AlexandreRouma/dc_sdr/README.md

# DEFCON SDR Badge

The firmware included here is not finished and the hardware isn't fully tested. Use at your own risk.

Make sure to read the license (the file is `/license`). The entire content of this repository is **NOT for commercial purposes**.
