AlexandreRouma/dc_sdr/full_assembly/full_assembly.FCStd

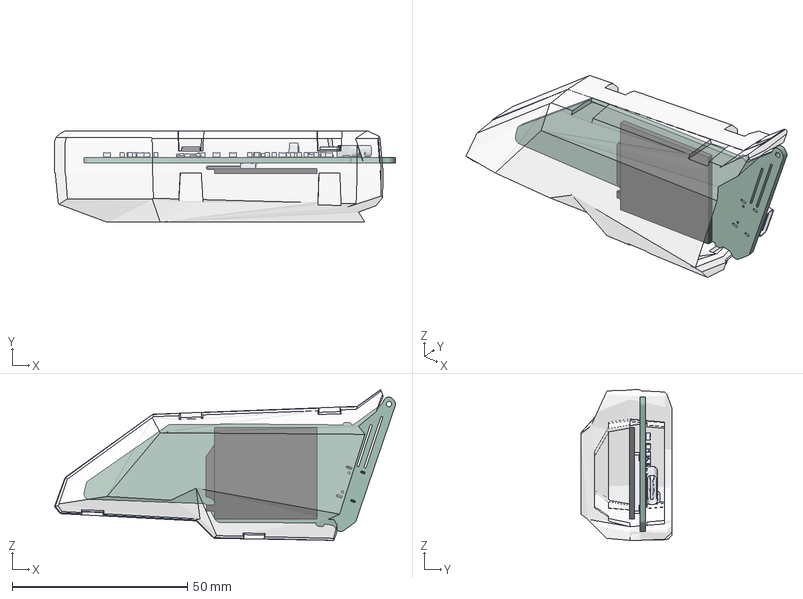
[picture p1: CAD file, 2023-07-31]
full_assembly/full_assembly.FCStd
97.3 x 26.1 x 43.2 mm
dc_sdr PCB
Badge chamber test fit
