AlexandreRouma/dc_sdr/lcd0_model/lcd0_model-BodyPad002.step

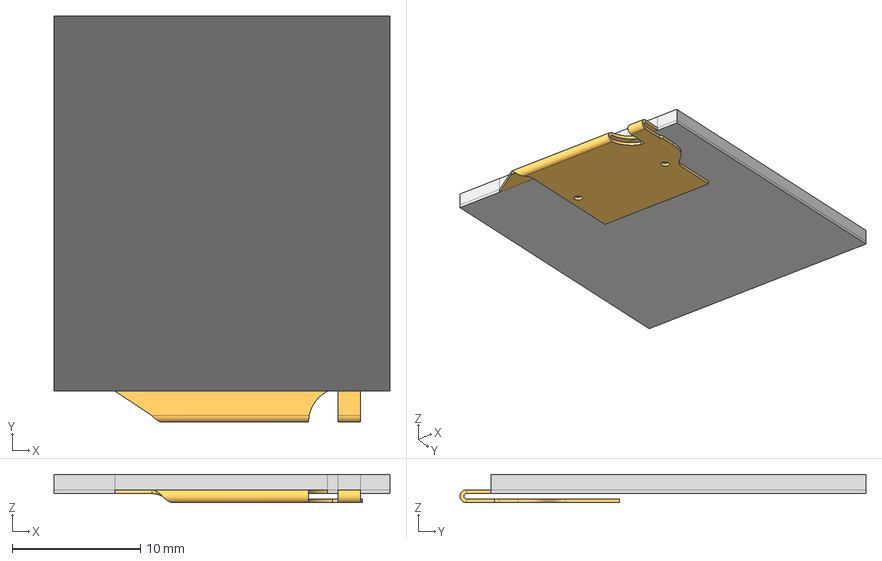
[picture p2: CAD file, 2023-07-31]
lcd0_model/lcd0_model-BodyPad002.step
26.2 x 31.6 x 2.20 mm
