AlexandreRouma/dc_sdr/lcd1_model/lcd1_model.FCStd

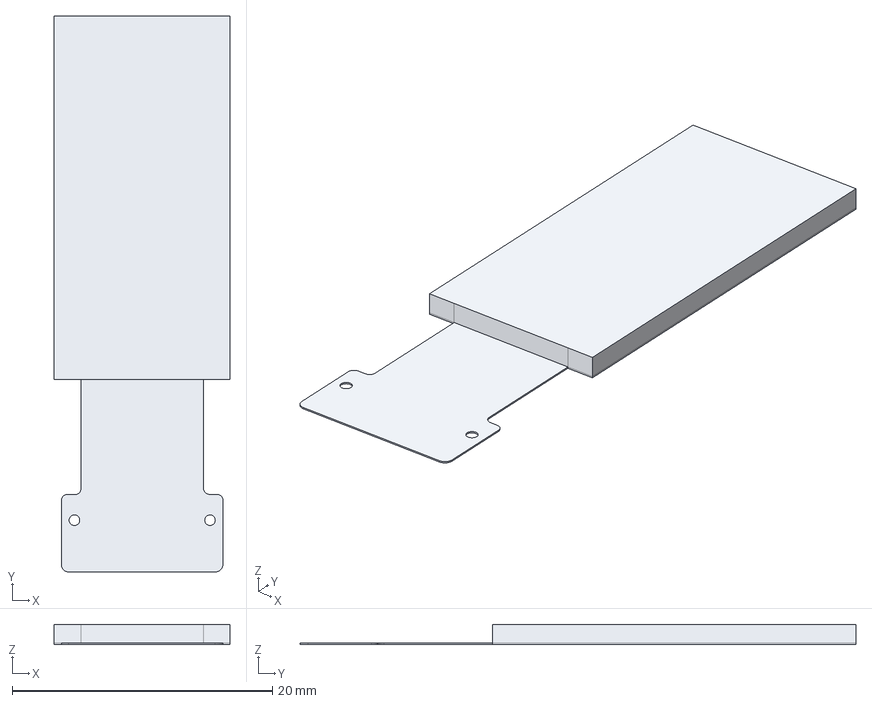
[picture p3: CAD file, 2023-07-31]
lcd1_model/lcd1_model.FCStd
13.5 x 42.8 x 1.54 mm
