AlexandreRouma/dc_sdr/oled/oled-BodyPad001.step

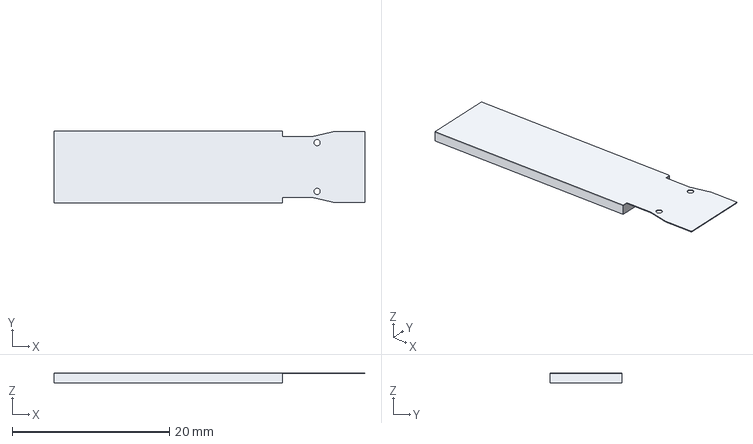
[picture p4: CAD file, 2023-07-31]
oled/oled-BodyPad001.step
39.6 x 9.20 x 1.30 mm
