AlexandreRouma/dc_sdr/lcd0_model/lcd0_model-BodyPad001.step

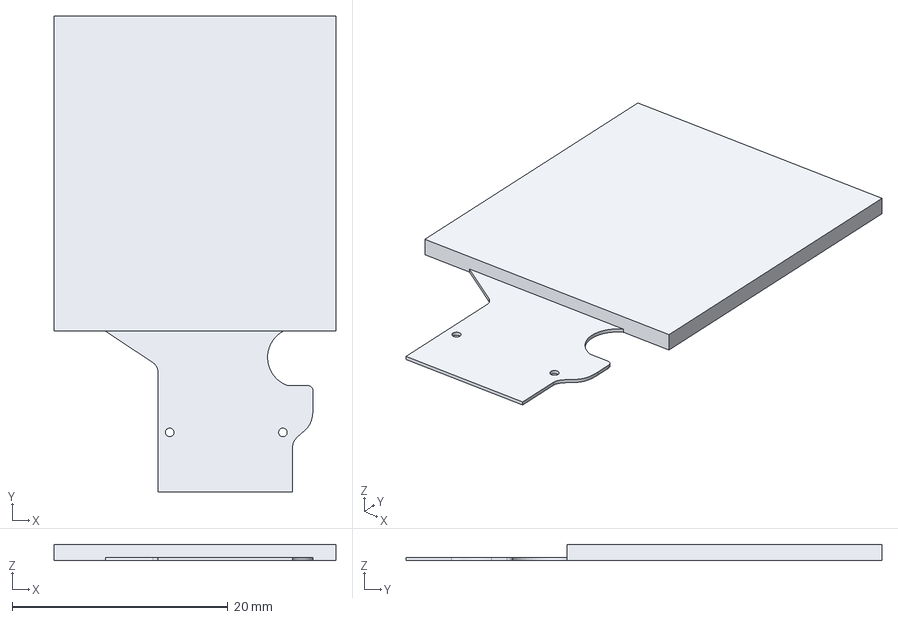
[picture p5: CAD file, 2023-07-31]
lcd0_model/lcd0_model-BodyPad001.step
26.2 x 44.1 x 1.50 mm
