AlexandreRouma/dc_sdr/(list of files, cad)

Other CAD files:
lcd0_model/lcd0_model.FCStd
lcd1_model/lcd1_model-BodyPad001.step
oled/oled.FCStd
