AlexandreRouma/dc_sdr/dc_sdr.kicad_pcb

## KiCad design dc_sdr.kicad_pcb (2023-07-31)

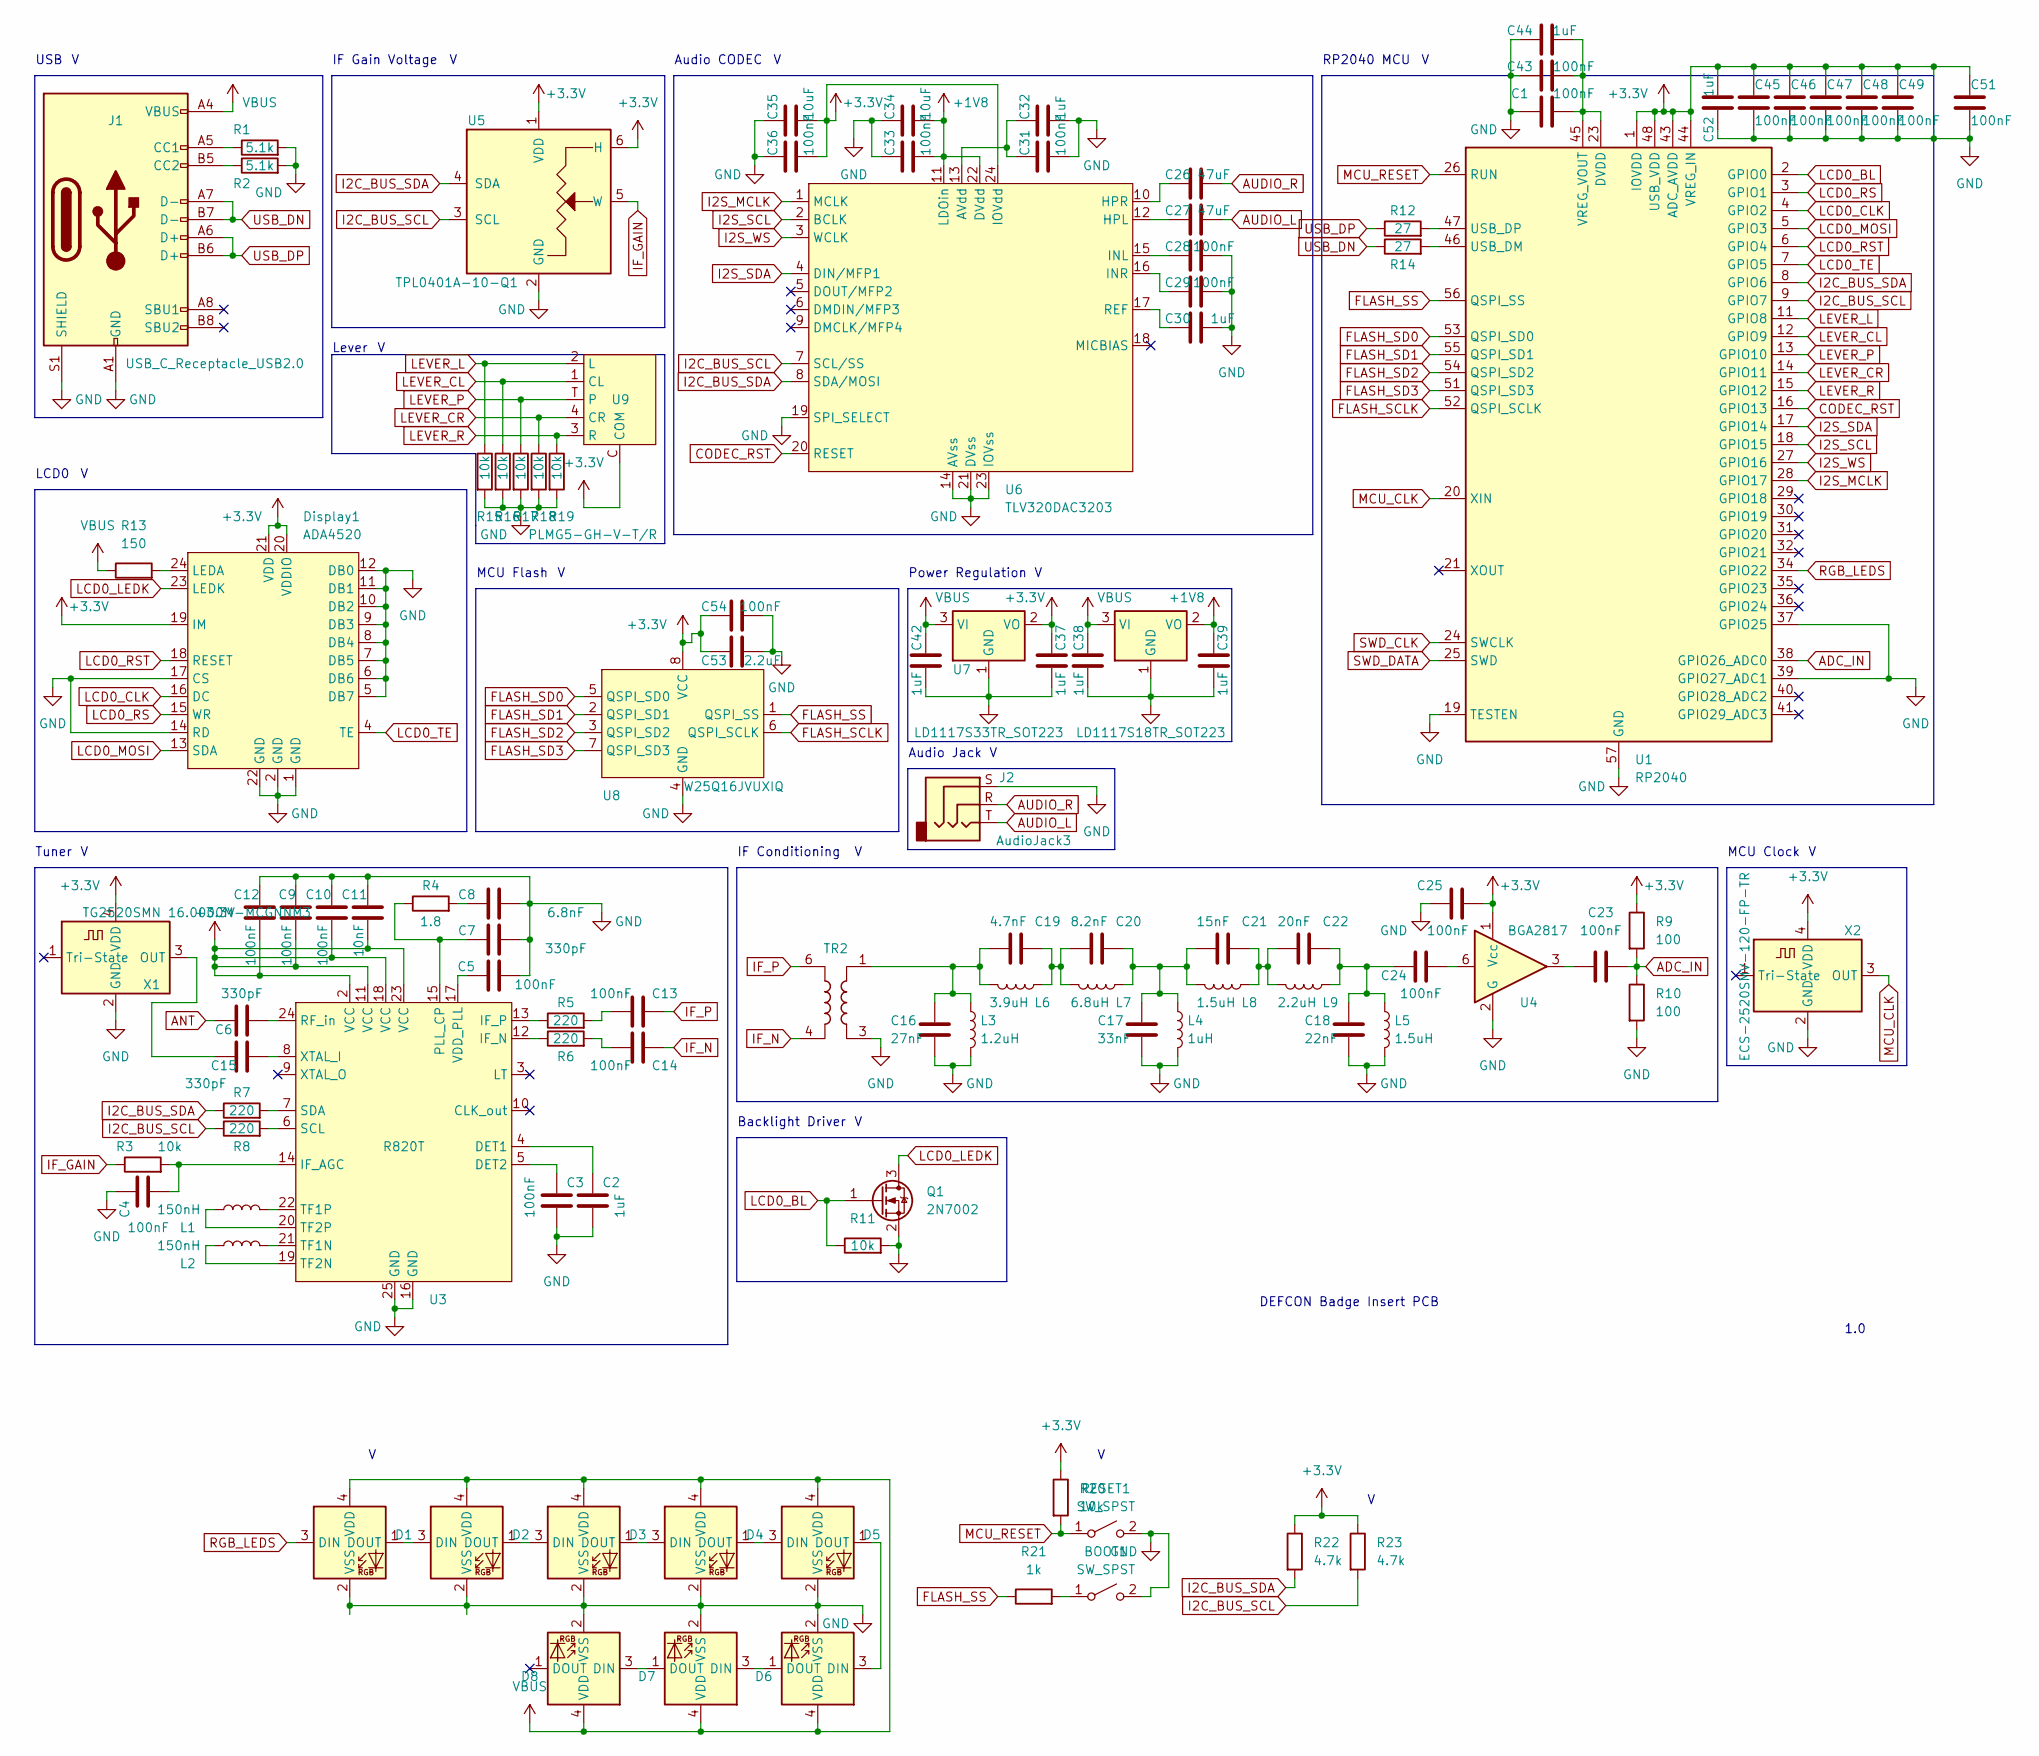
[picture p6: schematic dc_sdr.kicad_sch]

Parts:
BOOT1: SW_SPST; SW_SPST_B3U-1000P-B
C1, C3, C4, C5, C9, C10, C12, C13, C14, C23, C24, C25, C28, C29, C31, C33, C36, C43, C45, C46, C47, C48, C49, C51, C54: 100nF; C_0805_2012Metric_Pad1.18x1.45mm_HandSolder
C2, C30, C32, C37, C38, C39, C42, C44, C52: 1uF; C_0805_2012Metric_Pad1.18x1.45mm_HandSolder
C6, C7, C15: 330pF; C_0805_2012Metric_Pad1.18x1.45mm_HandSolder
C8: 6.8nF; C_0805_2012Metric_Pad1.18x1.45mm_HandSolder
C11: 10nF; C_0805_2012Metric_Pad1.18x1.45mm_HandSolder
C16: 27nF; C_0805_2012Metric_Pad1.18x1.45mm_HandSolder
C17: 33nF; C_0805_2012Metric_Pad1.18x1.45mm_HandSolder
C18: 22nF; C_0805_2012Metric_Pad1.18x1.45mm_HandSolder
C19: 4.7nF; C_0805_2012Metric_Pad1.18x1.45mm_HandSolder
C20: 8.2nF; C_0805_2012Metric_Pad1.18x1.45mm_HandSolder
C21: 15nF; C_0805_2012Metric_Pad1.18x1.45mm_HandSolder
C22: 20nF; C_0805_2012Metric_Pad1.18x1.45mm_HandSolder
C26, C27: 47uF; C_0805_2012Metric_Pad1.18x1.45mm_HandSolder
C34, C35: 10uF; C_0805_2012Metric_Pad1.18x1.45mm_HandSolder
C53: 2.2uF; C_0805_2012Metric_Pad1.18x1.45mm_HandSolder
D1, D2, D3, D4, D5, D6, D7, D8: LED_WS2812B-2020_PLCC4_2.0x2.0mm
Display1: ADA4520; AMPHENOL_SFV24R-2STE1HLF
J1: USB_C_Receptacle_USB2.0; USB_C_Receptacle_GCT_USB4105-xx-A_16P_TopMnt_Horizontal
J2: AudioJack3; Jack_3.5mm_CUI_SJ-3523-SMT_Horizontal
L1, L2: 150nH; L_0805_2012Metric_Pad1.15x1.40mm_HandSolder
L3: 1.2uH; L_0805_2012Metric_Pad1.15x1.40mm_HandSolder
L4: 1uH; L_0805_2012Metric_Pad1.15x1.40mm_HandSolder
L5, L8: 1.5uH; L_0805_2012Metric_Pad1.15x1.40mm_HandSolder
L6: 3.9uH; L_0805_2012Metric_Pad1.15x1.40mm_HandSolder
L7: 6.8uH; L_0805_2012Metric_Pad1.15x1.40mm_HandSolder
L9: 2.2uH; L_0805_2012Metric_Pad1.15x1.40mm_HandSolder
Q1: 2N7002; SOT-23
R1, R2: 5.1k; R_0805_2012Metric_Pad1.20x1.40mm_HandSolder
R3, R11, R15, R16, R17, R18, R19, R20: 10k; R_0805_2012Metric_Pad1.20x1.40mm_HandSolder
R4: 1.8; R_0805_2012Metric_Pad1.20x1.40mm_HandSolder
R5, R6, R7, R8: 220; R_0805_2012Metric_Pad1.20x1.40mm_HandSolder
R9, R10: 100; R_0805_2012Metric_Pad1.20x1.40mm_HandSolder
R12, R14: 27; R_0805_2012Metric_Pad1.20x1.40mm_HandSolder
R13: 150; R_0805_2012Metric_Pad1.20x1.40mm_HandSolder
R21: 1k; R_0805_2012Metric_Pad1.20x1.40mm_HandSolder
R22, R23: 4.7k; R_0805_2012Metric_Pad1.20x1.40mm_HandSolder
RESET1: SW_SPST; SW_SPST_B3U-1000P-B
TR2: Transformer_MiniCircuits_AT224-1A
U1: RP2040; QFN-56-1EP_7x7mm_P0.4mm_EP3.2x3.2mm
U3: R820T; QFN-24-1EP_4x4mm_P0.5mm_EP2.8x2.8mm
U4: BGA2817; SOT-363_SC-70-6
U5: TPL0401A-10-Q1; Texas_R-PDSO-G6
U6: TLV320DAC3203; VQFN-24-1EP_4x4mm_P0.5mm_EP2.5x2.5mm
U7: LD1117S33TR_SOT223; SOT-223-3_TabPin2
U8: W25Q16JVUXIQ; SON50P300X200X60-9N
U9: PLMG5-GH-V-T/R; PLMG5-GH-V-T_R
U11: LD1117S18TR_SOT223; SOT-223-3_TabPin2
X1: TG2520SMN 16.0000M-MCGNNM3; Oscillator_SMD_ECS_2520MV-xxx-xx-4Pin_2.5x2.0mm
X2: ECS-2520SMV-120-FP-TR; Oscillator_SMD_ECS_2520MV-xxx-xx-4Pin_2.5x2.0mm

Connections:
+1V8: C33.2, C34.2, C39.1, U6.11 (LDOin), U6.22 (DVdd), U11.2 (VO)
+3.3V: C9.2, C10.2, C11.2, C12.2, C25.2, C35.2, C36.2, C37.1, C45.1, C46.1, C47.1, C48.1, C49.1, C51.1, C52.2, C53.1, C54.1, Display1.19 (IM), Display1.20 (VDDIO), Display1.21 (VDD), R9.1, R20.1, R22.1, R23.1, U1.1 (IOVDD), U1.10 (IOVDD), U1.22 (IOVDD), U1.33 (IOVDD), U1.42 (IOVDD), U1.43 (ADC_AVDD), U1.44 (VREG_IN), U1.48 (USB_VDD), U1.49 (IOVDD), U3.2 (VCC), U3.11 (VCC), U3.18 (VCC), U3.23 (VCC), U4.1 (Vcc), U5.1 (VDD), U5.6 (H), U6.24 (IOVdd), U7.2 (VO), U8.8 (VCC), U9.C (COM), X1.4 (VDD), X2.4 (VDD); also elsewhere on the board
ADC_IN: C23.2, R9.2, R10.1, U1.38 (GPIO26_ADC0)
ANT: C6.1
AUDIO_L: C27.2, J2.T
AUDIO_R: C26.2, J2.R
CODEC_RST: U1.16 (GPIO13), U6.20 (RESET)
FLASH_SCLK: U1.52 (QSPI_SCLK), U8.6 (QSPI_SCLK)
FLASH_SD0: U1.53 (QSPI_SD0), U8.5 (QSPI_SD0)
FLASH_SD1: U1.55 (QSPI_SD1), U8.2 (QSPI_SD1)
FLASH_SD2: U1.54 (QSPI_SD2), U8.3 (QSPI_SD2)
FLASH_SD3: U1.51 (QSPI_SD3), U8.7 (QSPI_SD3)
FLASH_SS: R21.1, U1.56 (QSPI_SS), U8.1 (QSPI_SS)
GND: BOOT1.2 (B), C1.1, C2.2, C3.2, C4.1, C5.2, C7.2, C8.2, C9.1, C10.1, C11.1, C12.1, C16.2, C17.2, C18.2, C25.1, C28.2, C29.2, C30.2, C31.2, C32.2, C33.1, C34.1, C35.1, C36.1, C37.2, C38.2, C39.2, C42.2, C43.1, C44.1, C45.2, C46.2, C47.2, C48.2, C49.2, C51.2, C52.1, C53.2, C54.2, D1.2 (VSS), D2.2 (VSS), D3.2 (VSS), D4.2 (VSS), D5.2 (VSS), D6.2 (VSS), D7.2 (VSS), D8.2 (VSS), Display1.1 (GND), Display1.2 (GND), Display1.5 (DB7), Display1.6 (DB6), Display1.7 (DB5), Display1.8 (DB4), Display1.9 (DB3), Display1.10 (DB2), Display1.11 (DB1), Display1.12 (DB0), Display1.14 (RD), Display1.17 (CS), Display1.22 (GND), J1.A1 (GND), J1.A12 (GND), J1.B1 (GND), J1.B12 (GND), J1.S1 (SHIELD), J2.S, L3.2, L4.2, L5.2, Q1.2 (S), R1.2, R2.2, R10.2, R11.2, R15.2, R16.2, R17.2, R18.2, R19.2, RESET1.2 (B), TR2.3, U1.19 (TESTEN), U1.37 (GPIO25), U1.39 (GPIO27_ADC1), U1.57 (GND), U3.16 (GND), U3.25 (GND), U4.2 (G), U4.4 (G), U4.5 (G), U5.2 (GND), U6.14 (AVss), U6.19 (SPI_SELECT), U6.21 (DVss), U6.23 (IOVss), U7.1 (GND), U8.4 (GND), U11.1 (GND), X1.2 (GND), X2.2 (GND); also elsewhere on the board
I2C_BUS_SCL: R8.1, R23.2, U1.9 (GPIO7), U5.3 (SCL), U6.7 (SCL/SS)
I2C_BUS_SDA: R7.1, R22.2, U1.8 (GPIO6), U5.4 (SDA), U6.8 (SDA/MOSI)
I2S_MCLK: U1.28 (GPIO17), U6.1 (MCLK)
I2S_SCL: U1.18 (GPIO15), U6.2 (BCLK)
I2S_SDA: U1.17 (GPIO14), U6.4 (DIN/MFP1)
I2S_WS: U1.27 (GPIO16), U6.3 (WCLK)
IF_GAIN: R3.1, U5.5 (W)
IF_N: C14.2, TR2.4
IF_P: C13.2, TR2.6
LCD0_BL: Q1.1 (G), R11.1, U1.2 (GPIO0)
LCD0_CLK: Display1.16 (DC), U1.4 (GPIO2)
LCD0_LEDK: Display1.23 (LEDK), Q1.3 (D)
LCD0_MOSI: Display1.13 (SDA), U1.5 (GPIO3)
LCD0_RS: Display1.15 (WR), U1.3 (GPIO1)
LCD0_RST: Display1.18 (RESET), U1.6 (GPIO4)
LCD0_TE: Display1.4 (TE), U1.7 (GPIO5)
LEVER_CL: R16.1, U1.12 (GPIO9), U9.1 (CL)
LEVER_CR: R18.1, U1.14 (GPIO11), U9.4 (CR)
LEVER_L: R15.1, U1.11 (GPIO8), U9.2 (L)
LEVER_P: R17.1, U1.13 (GPIO10), U9.T
LEVER_R: R19.1, U1.15 (GPIO12), U9.3 (R)
MCU_CLK: U1.20 (XIN), X2.3 (OUT)
MCU_RESET: R20.2, RESET1.1 (A), U1.26 (RUN)
unnamed: BOOT1.1 (A), R21.2
unnamed: C8.1, R4.2
unnamed: C13.1, R5.2
unnamed: C14.1, R6.2
unnamed: C16.1, C19.2, L3.1, L6.2, TR2.1
unnamed: C17.1, C20.1, C21.2, L4.1, L7.1, L8.2
unnamed: C18.1, C22.1, C24.1, L5.1, L9.1
unnamed: C19.1, C20.2, L6.1, L7.2
unnamed: C21.1, C22.2, L8.1, L9.2
unnamed: C23.1, U4.3
unnamed: C24.2, U4.6
unnamed: D1.1 (DOUT), D2.3 (DIN)
unnamed: D2.1 (DOUT), D3.3 (DIN)
unnamed: D3.1 (DOUT), D4.3 (DIN)
unnamed: D4.1 (DOUT), D5.3 (DIN)
unnamed: D5.1 (DOUT), D6.3 (DIN)
unnamed: D6.1 (DOUT), D7.3 (DIN)
unnamed: D7.1 (DOUT), D8.3 (DIN)
unnamed: Display1.24 (LEDA), R13.2
unnamed: J1.A5 (CC1), R1.1
unnamed: J1.B5 (CC2), R2.1
unnamed: R14.2, U1.46 (USB_DM)
unnamed: R12.2, U1.47 (USB_DP)
unnamed: C1.2, C43.2, C44.2, U1.23 (DVDD), U1.45 (VREG_VOUT), U1.50 (DVDD)
unnamed: C2.1, U3.4 (DET1)
unnamed: C3.1, U3.5 (DET2)
unnamed: C4.2, R3.2, U3.14 (IF_AGC)
unnamed: R6.1, U3.12 (IF_N)
unnamed: R5.1, U3.13 (IF_P)
unnamed: C7.1, R4.1, U3.15 (PLL_CP)
unnamed: C6.2, U3.24 (RF_in)
unnamed: R8.2, U3.6 (SCL)
unnamed: R7.2, U3.7 (SDA)
unnamed: L2.2, U3.21 (TF1N)
unnamed: L1.2, U3.22 (TF1P)
unnamed: L2.1, U3.19 (TF2N)
unnamed: L1.1, U3.20 (TF2P)
unnamed: C5.1, U3.17 (VDD_PLL)
unnamed: C15.2, U3.8 (XTAL_I)
unnamed: C31.1, C32.1, U6.13 (AVdd)
unnamed: C27.1, U6.12 (HPL)
unnamed: C26.1, U6.10 (HPR)
unnamed: C28.1, U6.15 (INL)
unnamed: C29.1, U6.16 (INR)
unnamed: C30.1, U6.17 (REF)
unnamed: C15.1, X1.3 (OUT)
RGB_LEDS: D1.3 (DIN), U1.34 (GPIO22)
SWD_CLK: U1.24 (SWCLK)
SWD_DATA: U1.25 (SWD)
USB_DN: J1.A7 (D-), J1.B7 (D-), R14.1
USB_DP: J1.A6 (D+), J1.B6 (D+), R12.1
VBUS: C38.1, C42.1, D1.4 (VDD), D2.4 (VDD), D3.4 (VDD), D4.4 (VDD), D5.4 (VDD), D6.4 (VDD), D7.4 (VDD), D8.4 (VDD), J1.A4 (VBUS), J1.A9 (VBUS), J1.B4 (VBUS), J1.B9 (VBUS), R13.1, U7.3 (VI), U11.3 (VI)

Notes on the sheet:
DEFCON Badge Insert PCB
1.0
IF Conditioning
IF Gain Voltage
LCD0
Lever
Power Regulation
Tuner
USB
Backlight Driver
RP2040 MCU
MCU Clock
MCU Flash
Audio CODEC
Audio Jack

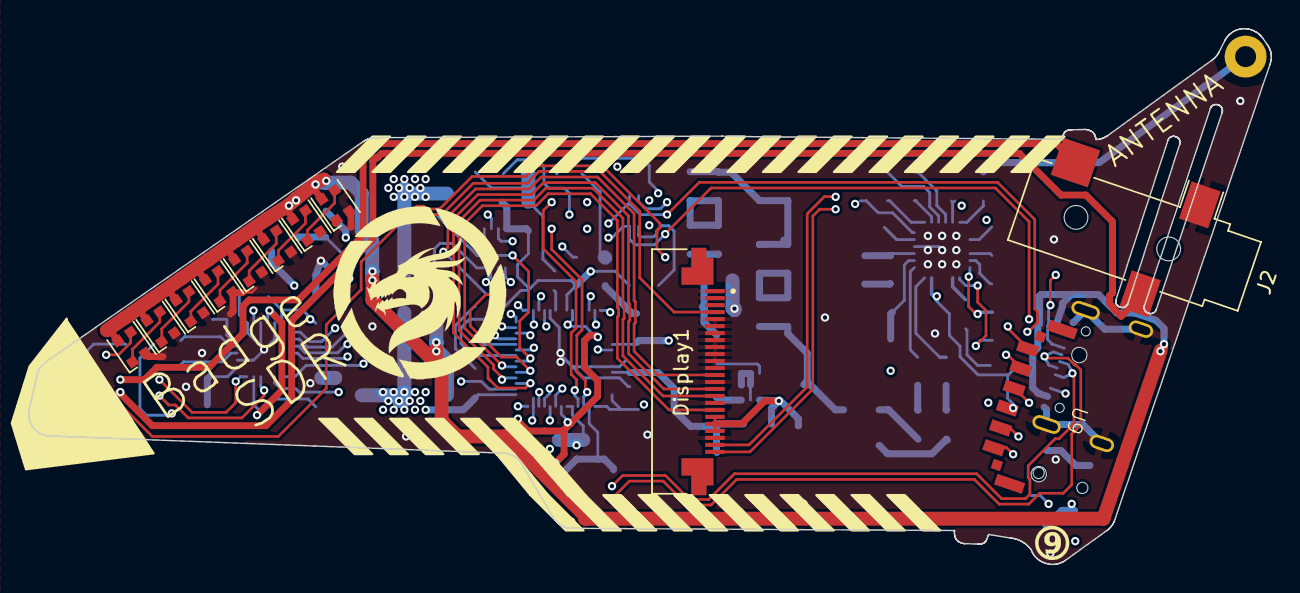
[picture p7: board dc_sdr.kicad_pcb from above]

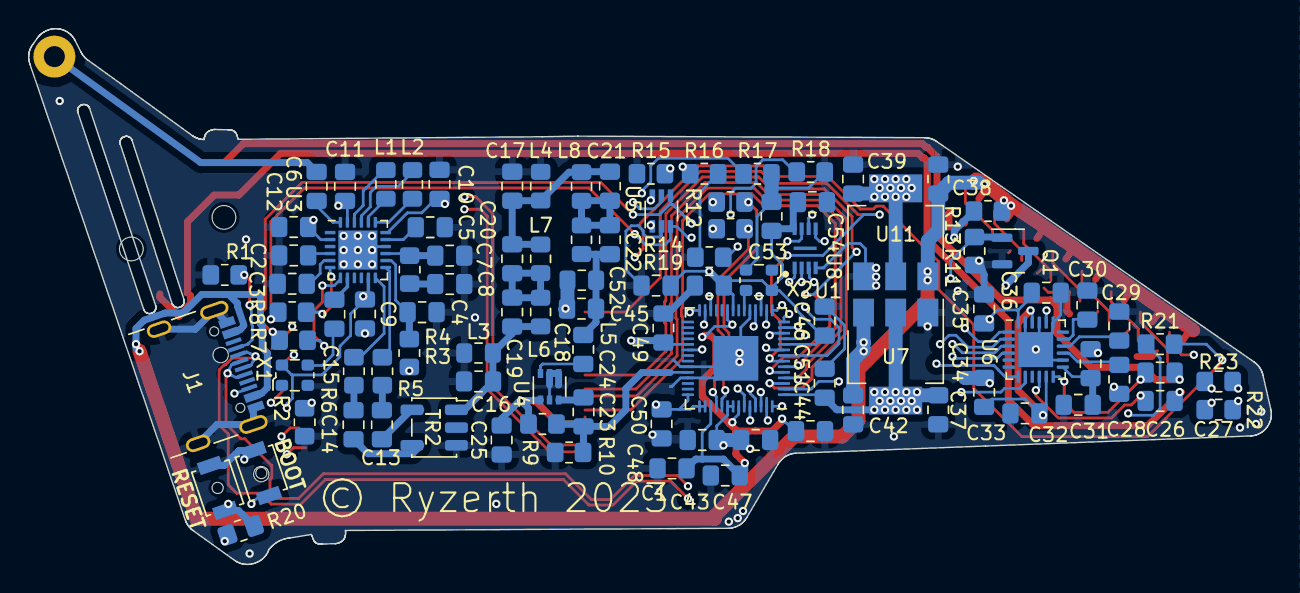
[picture p8: board dc_sdr.kicad_pcb from below]

Board: 4 copper layers, 88.9 x 38.3 mm, 110 parts (99 on the bottom side), 86 nets.

Other parts of the board:
C50: 100nF; C_0805_2012Metric_Pad1.18x1.45mm_HandSolder

Their connections:
+3.3V: C50.1; also elsewhere on the board
GND: C50.2; also elsewhere on the board
