AlexandreRouma/dc_sdr/(notices)

Notices in the files:
dc_sdr.kicad_pcb:
© Ryzerth 2023
